Ir0nC0wb0y/Split-Flap/Electronics/SF_Master-Controller/Display Controller.xlsx

Reference | Qty | Value | DNP | Digikey Cart | Have
C2,C4,C8 | 3 | 10uF |  |  | x
C1,C3,C9,C10,C11 | 5 | 0.1uF |  |  | x
D1 | 1 | LTST-S220GKT |  | x
J1 | 1 | S2B-XH-A-1 |  | x
J2 | 1 | S4B-XH-A-1 |  | x
J3 | 1 | Pin Header (6 pin) |  |  | x
J4 | 1 | Pin Header (4 Pin) |  |  | x
Q1 | 1 | FMB2222A |  | x
R7 | 1 | 143R |  | x
R8 | 1 | 1k |  |  | x
R9,R10,R11,R12 | 4 | 1.8k |  | x
R13,R14,R15,R16 | 4 | 10k |  |  | x
R17,R18 | 2 | 1.8k | DNP |  | x
SW3,SW4 | 2 | SW_SPST |  | x
U2 | 1 | LD1117S33TR |  | x
U3 | 1 | LD1117S50TR |  | x
U4 | 1 | TCA9406DCUR |  | x
U5 | 1 | ESP32-WROOM-32E |  | x
