Ir0nC0wb0y/Split-Flap/Electronics/SF_Digit-Controller/Split-Flap_Digit-Controller_SMD.step

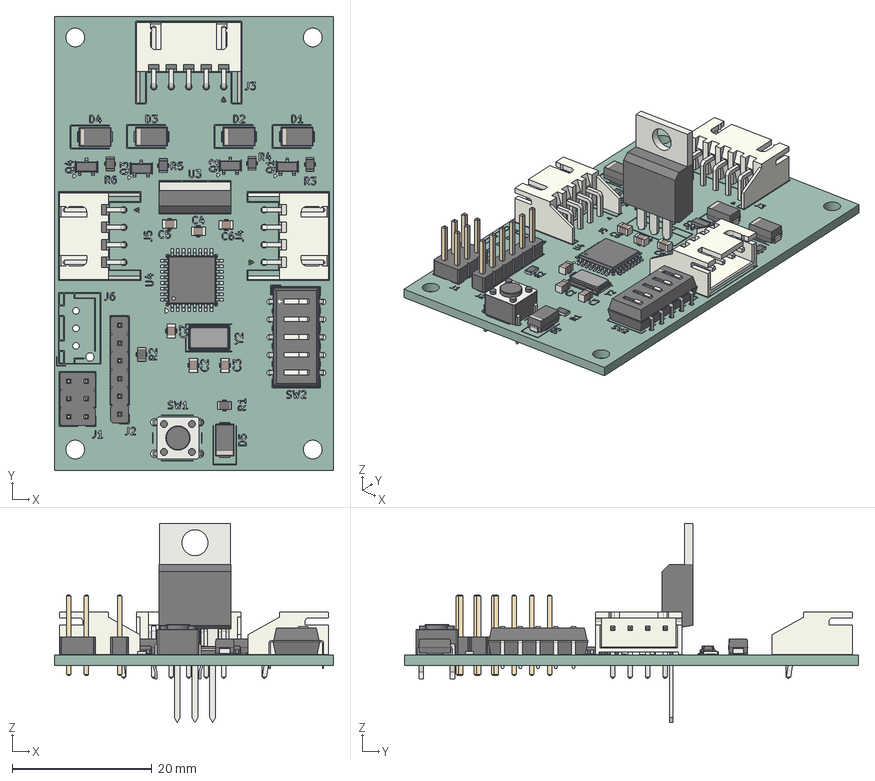
[picture p1: CAD file, 2025-06-14]
Electronics/SF_Digit-Controller/Split-Flap_Digit-Controller_SMD.step
40.0 x 65.0 x 28.5 mm
PinHeader_2x03_P2.54mm_Vertical
D_SMA x 5
TO-220-3_Vertical
C_0805_2012Metric x 6
SW_PUSH_6mm
SOT-23-3 x 4
R_0805_2012Metric x 6
Crystal_SMD_0603-2Pin_6.0x3.5mm
SW_DIP_SPSTx05_Slide_6.7x14.26mm_W7.62mm_P2.54mm_LowProfile
JST_XH_S4B-XH-A_1x04_P2.50mm_Horizontal x 2
TQFP-32_7x7mm_P0.8mm
PinHeader_1x06_P2.54mm_Vertical
JST_XH_S5B-XH-A_1x05_P2.50mm_Horizontal
Split-Flap_Digit-Controller_SMD_silkscreen
Split-Flap_Digit-Controller_SMD_PCB
