Ir0nC0wb0y/Split-Flap/Electronics/SF_Master-Controller/Display Controller.kicad_pcb

## KiCad design Electronics/SF_Master-Controller/Display Controller.kicad_pcb (2025-06-14)

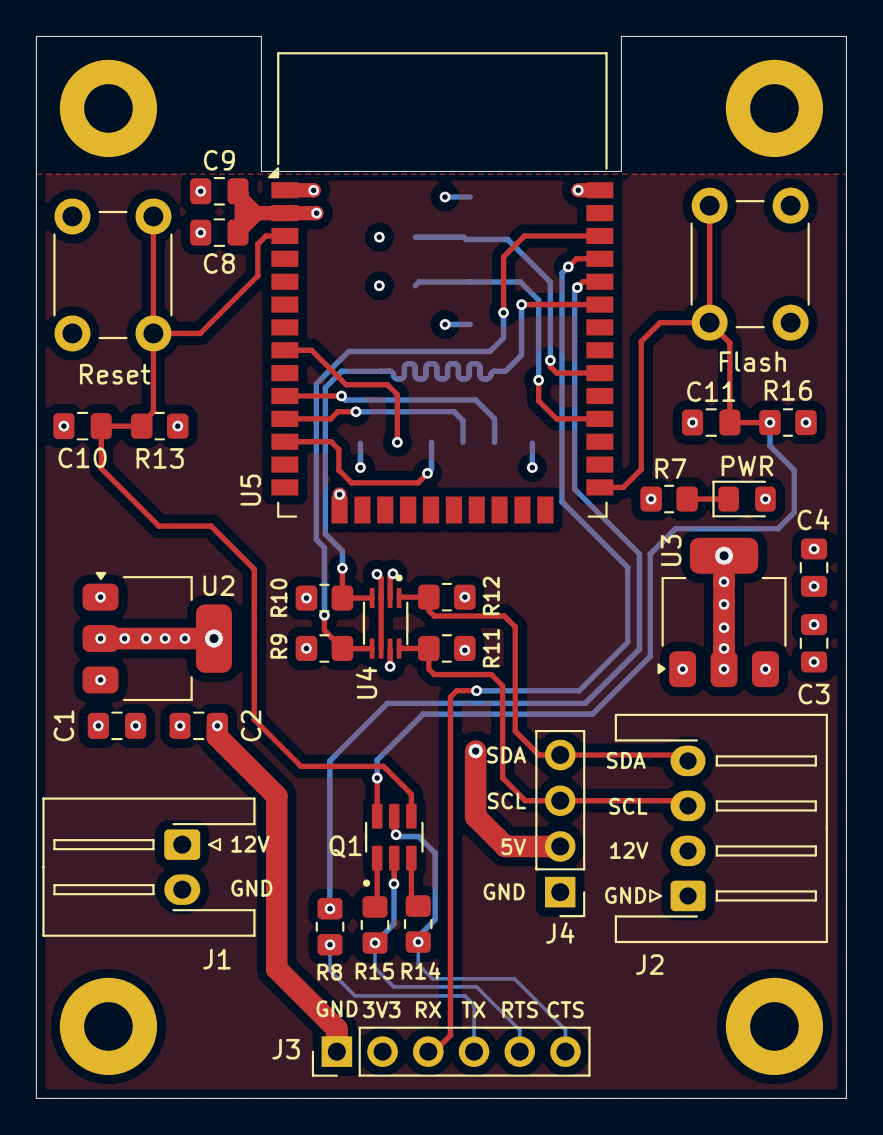
[picture p2: board Display Controller.kicad_pcb from above]

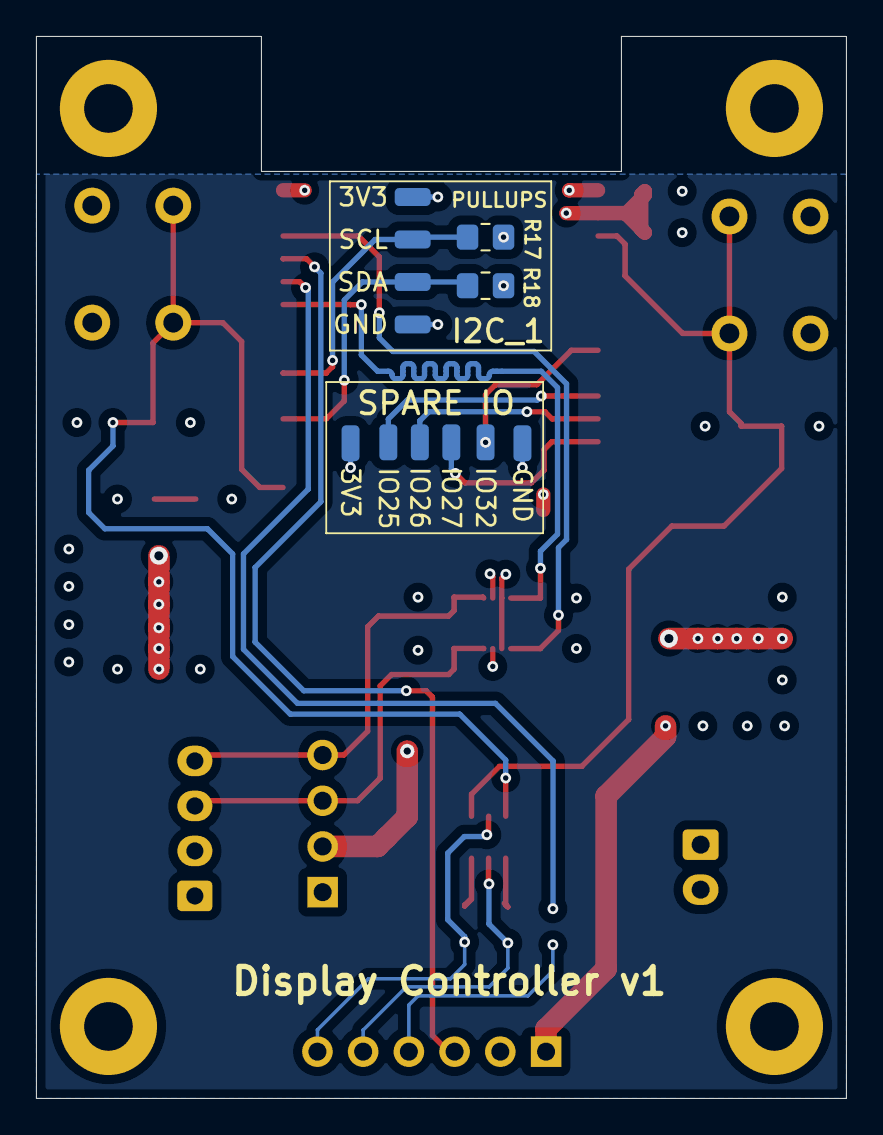
[picture p3: board Display Controller.kicad_pcb from below]

Board: 4 copper layers, 45.0 x 59.0 mm, 46 parts (12 on the bottom side), 24 nets.

Parts:
C1, C2, C3, C4: C; C_0805_2012Metric_Pad1.18x1.45mm_HandSolder
C8: 10uF; C_0805_2012Metric_Pad1.18x1.45mm_HandSolder
C9, C10, C11: 0.1uF; C_0805_2012Metric_Pad1.18x1.45mm_HandSolder
D1: LED; LED_0805_2012Metric_Pad1.15x1.40mm_HandSolder
H1, H2, H3, H4: MountingHole_Pad; MountingHole_2.7mm_M2.5_Pad
J1: Conn_01x02_Pin; JST_XH_S2B-XH-A-1_1x02_P2.50mm_Horizontal
J2: Conn_01x04_Pin; JST_XH_S4B-XH-A-1_1x04_P2.50mm_Horizontal
J3: Conn_01x06_Pin; PinHeader_1x06_P2.54mm_Vertical
J4: Conn_01x04_Pin; PinHeader_1x04_P2.54mm_Vertical
Q1: FMB2222A; SOT95P280X110-6N
R7: 150R; R_0805_2012Metric_Pad1.20x1.40mm_HandSolder
R8: 1k; R_0805_2012Metric_Pad1.20x1.40mm_HandSolder
R9, R10, R11, R12, R13, R14, R15, R16, R17, R18: 10k; R_0805_2012Metric_Pad1.20x1.40mm_HandSolder
SW3, SW4: SW_SPST; SW_PUSH_6mm_H4.3mm
TP1, TP2, TP3, TP4, TP5, TP6, TP7, TP8, TP9, TP10: TestPoint_Small; SolderWirePad_1x01_SMD_1x2mm
U2: LD1117S33TR_SOT223; SOT-223-3_TabPin2
U3: LD1117S50TR_SOT223; SOT-223-3_TabPin2
U4: TCA9406DCUR; SOP50P310X90-8N
U5: ESP32-WROOM-32E; ESP32-WROOM-32D

Connections:
+3V3: C2.1, C8.2, C9.2, J3.1, R9.1, R10.1, R13.1, R16.1, R17.1, R18.1, TP1.1, TP5.1, U2.2 (VO), U4.3 (VCCA), U4.6 (OE), U5.2 (VDD)
+5V: C4.1, D1.2 (A), J4.2, R11.1, R12.1, U3.2 (VO), U4.7 (VCCB)
+12V: C1.2, C3.2, J1.1, J2.2, U2.3 (VI), U3.3 (VI)
/ESP32/EN: C10.2, Q1.4, R13.2, SW3.2 (B), U5.3 (EN)
/ESP32/I2C_SCL_SPARE: R17.2, TP2.1, U5.30 (IO18)
/ESP32/I2C_SDA_SPARE: R18.2, TP3.1, U5.28 (IO17)
/ESP32/IO0: C11.2, Q1.6, R16.2, SW4.1 (A), U5.25 (IO0)
/ESP32/IO25: TP6.1, U5.10 (IO25)
/ESP32/IO26: TP7.1, U5.11 (IO26)
/ESP32/IO27: TP9.1, U5.12 (IO27)
/ESP32/IO32: TP10.1, U5.8 (IO32)
/I2C_SCL_5V: J2.3, J4.3, R11.2, U4.8 (SCL_B)
/I2C_SDA_5V: J2.4, J4.4, R12.2, U4.1 (SDA_B)
FTDI_CTS: J3.6, Q1.5, R14.1
FTDI_RTS: J3.5, Q1.2, R15.2
FTDI_RX: J3.3, U5.35 (TXD0/IO1)
FTDI_TX: R8.2, U5.34 (RXD0/IO3)
GND: C1.1, C2.2, C3.1, C4.2, C8.1, C9.1, C10.1, C11.1, J1.2, J2.1, J3.2, J4.1, R7.2, SW3.1 (A), SW4.2 (B), TP4.1, TP8.1, U2.1 (GND), U3.1 (GND), U4.2 (GND), U5.1 (GND), U5.15 (GND), U5.38 (GND)
I2C_SCL_3V3: R9.2, U4.5 (SCL_A), U5.36 (IO22)
I2C_SDA_3V3: R10.2, U4.4 (SDA_A), U5.33 (IO21)
unnamed: D1.1 (K), R7.1
unnamed: J3.4, R8.1
unnamed: Q1.1, R15.1
unnamed: Q1.3, R14.2
