Ir0nC0wb0y/Split-Flap/Electronics/SF_Digit-Controller/Split-Flap_Digit-Controller_SMD.kicad_pcb

## KiCad design Electronics/SF_Digit-Controller/Split-Flap_Digit-Controller_SMD.kicad_pcb (2025-05-09)

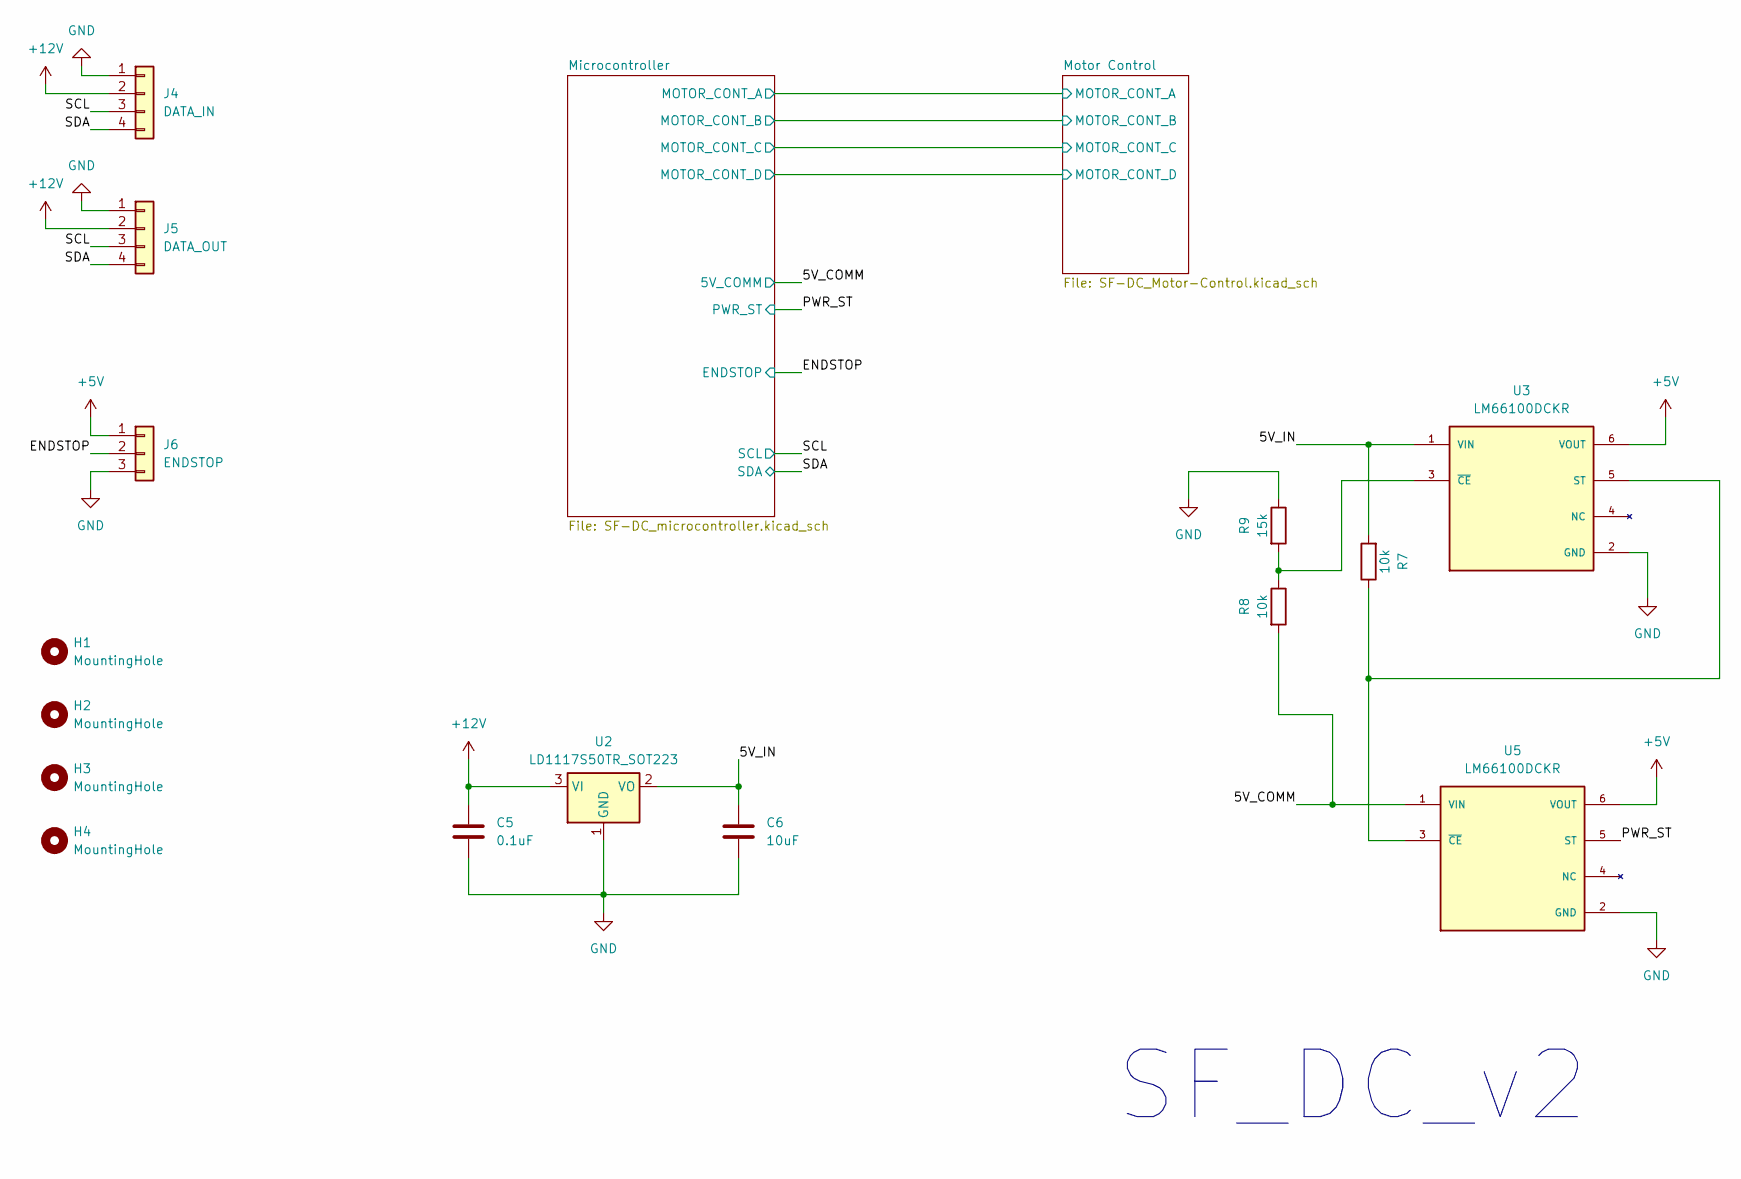
[picture p4: schematic Split-Flap_Digit-Controller_SMD.kicad_sch]

Parts:
C5: 0.1uF; LED_0805_2012Metric_Pad1.15x1.40mm_HandSolder
C6: 10uF; LED_0805_2012Metric_Pad1.15x1.40mm_HandSolder
H1, H2, H3, H4: MountingHole; MountingHole_2.7mm_M2.5_DIN965_Pad_TopBottom
J4: DATA_IN; JST_XH_S4B-XH-A-1_1x04_P2.50mm_Horizontal
J5: DATA_OUT; JST_XH_S4B-XH-A-1_1x04_P2.50mm_Horizontal
J6: ENDSTOP; JST_XH_S3B-XH-A-1_1x03_P2.50mm_Horizontal
R7, R8: 10k; R_0805_2012Metric_Pad1.20x1.40mm_HandSolder
R9: 15k; R_0805_2012Metric_Pad1.20x1.40mm_HandSolder
U2: LD1117S50TR_SOT223; SOT-223-3_TabPin2
U3, U5: LM66100DCKR; SOT65P210X110-6N; PARTREV Rev. A

Connections:
+5V: J6.1, U3.6 (VOUT), U5.6 (VOUT); also elsewhere on the board
+12V: C5.1, J4.2, J5.2, U2.3 (VI); also elsewhere on the board
/5V_COMM: R8.2, U5.1 (VIN); also elsewhere on the board
/5V_IN: C6.1, R7.2, U2.2 (VO), U3.1 (VIN)
/ENDSTOP: J6.2; also elsewhere on the board
/PWR_ST: U5.5 (ST); also elsewhere on the board
/SCL: J4.3, J5.3; also elsewhere on the board
/SDA: J4.4, J5.4; also elsewhere on the board
GND: C5.2, C6.2, J4.1, J5.1, J6.3, R9.1, U2.1 (GND), U3.2 (GND), U5.2 (GND); also elsewhere on the board
unnamed: R7.1, U3.5 (ST), U5.3 (~CE)
unnamed: R8.1, R9.2, U3.3 (~CE)

Notes on the sheet:
SF_DC_v2

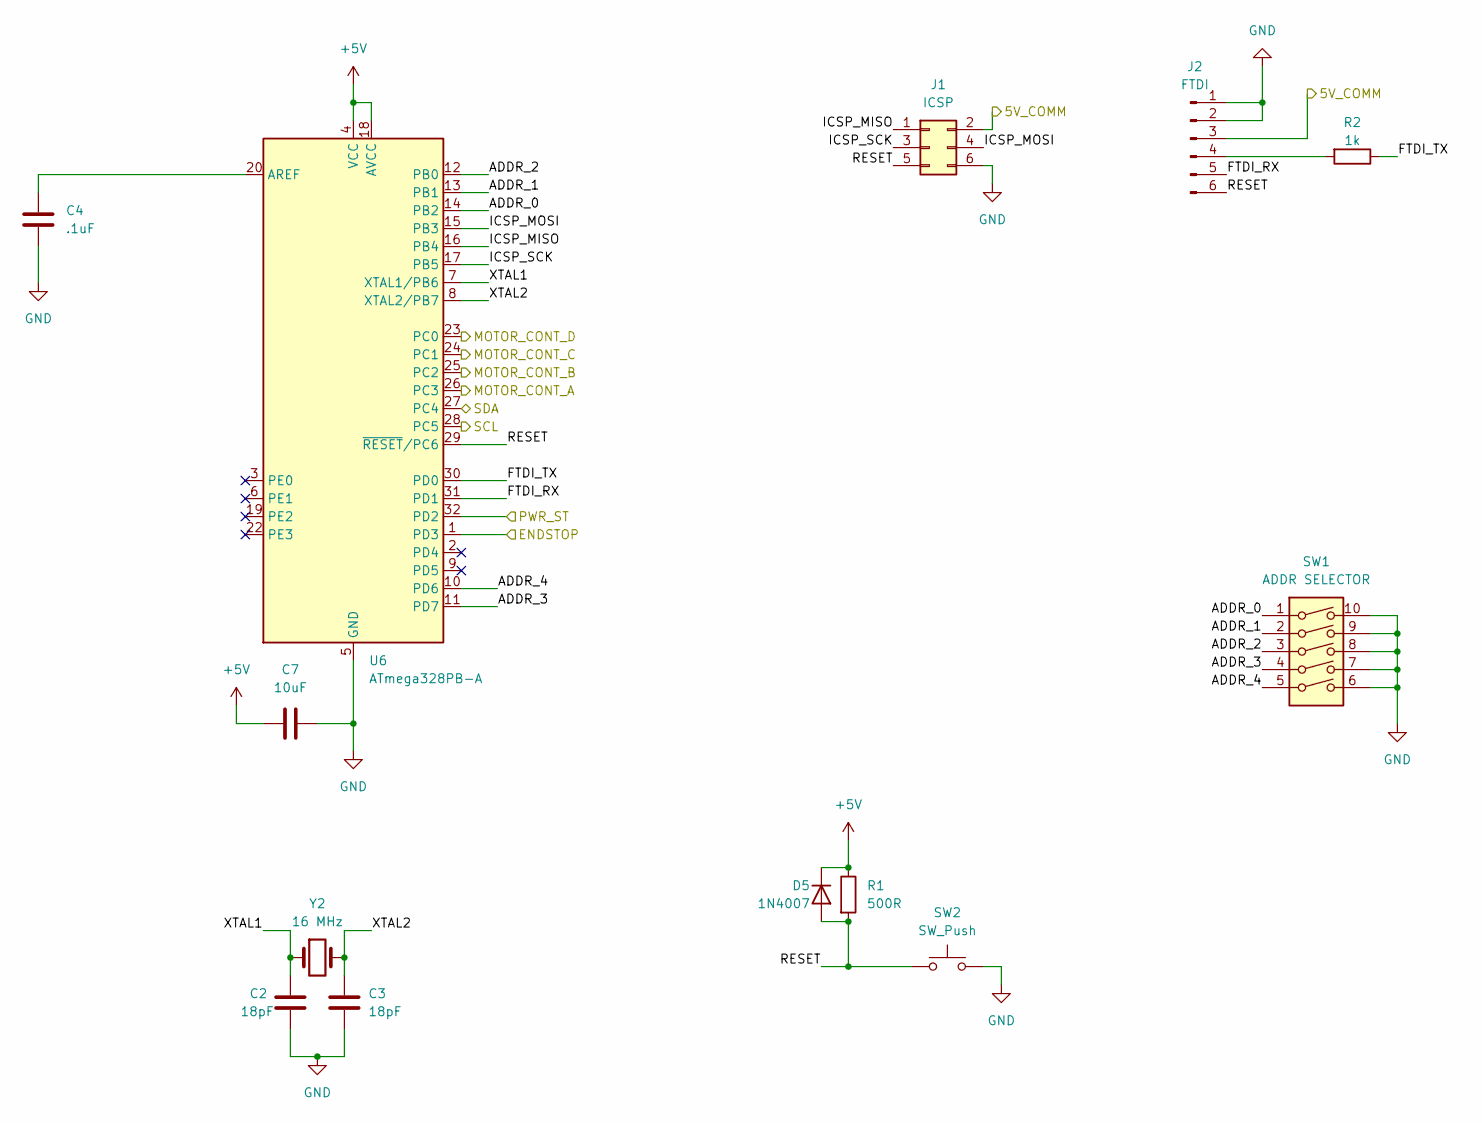
[picture p5: schematic SF-DC_microcontroller.kicad_sch]

Parts:
C2: 18pF; C_0805_2012Metric_Pad1.18x1.45mm_HandSolder; Part Number FG28C0G1H180JNT06
C3: 18pF; C_0805_2012Metric_Pad1.18x1.45mm_HandSolder; part_no FG28C0G1H180JNT06
C4: .1uF; C_0805_2012Metric_Pad1.18x1.45mm_HandSolder
C7: 10uF; C_0805_2012Metric_Pad1.18x1.45mm_HandSolder
D5: 1N4007; D_SMA_Handsoldering
J1: ICSP; PinHeader_2x03_P2.54mm_Vertical
J2: FTDI; PinHeader_1x06_P2.54mm_Vertical
R1: 500R; R_0805_2012Metric_Pad1.20x1.40mm_HandSolder
R2: 1k; R_0805_2012Metric_Pad1.20x1.40mm_HandSolder
SW1: ADDR SELECTOR; SW_DIP_SPSTx05_Slide_6.7x14.26mm_W7.62mm_P2.54mm_LowProfile
SW2: SW_Push; SW_PUSH_6mm
U6: ATmega328PB-A; TQFP-32_7x7mm_P0.8mm
Y2: 16 MHz; Crystal_SMD_0603-2Pin_6.0x3.5mm_HandSoldering

Connections:
+5V: C7.2, D5.1 (K), R1.1, U6.4 (VCC), U6.18 (AVCC); also elsewhere on the board
/5V_COMM: J1.2, J2.3; also elsewhere on the board
/ENDSTOP: U6.1 (PD3); also elsewhere on the board
/Microcontroller/ADDR_0: SW1.1, U6.14 (PB2)
/Microcontroller/ADDR_1: SW1.2, U6.13 (PB1)
/Microcontroller/ADDR_2: SW1.3, U6.12 (PB0)
/Microcontroller/ADDR_3: SW1.4, U6.11 (PD7)
/Microcontroller/ADDR_4: SW1.5, U6.10 (PD6)
/Microcontroller/FTDI_RX: J2.5, U6.31 (PD1)
/Microcontroller/FTDI_TX: R2.1, U6.30 (PD0)
/Microcontroller/ICSP_MISO: J1.1, U6.16 (PB4)
/Microcontroller/ICSP_MOSI: J1.4, U6.15 (PB3)
/Microcontroller/ICSP_SCK: J1.3, U6.17 (PB5)
/Microcontroller/MOTOR_CONT_A: U6.26 (PC3); also elsewhere on the board
/Microcontroller/MOTOR_CONT_B: U6.25 (PC2); also elsewhere on the board
/Microcontroller/MOTOR_CONT_C: U6.24 (PC1); also elsewhere on the board
/Microcontroller/MOTOR_CONT_D: U6.23 (PC0); also elsewhere on the board
/Microcontroller/RESET: D5.2 (A), J1.5, J2.6, R1.2, SW2.1, U6.29 (~RESET/PC6)
/Microcontroller/XTAL1: C2.2, U6.7 (XTAL1/PB6), Y2.1
/Microcontroller/XTAL2: C3.2, U6.8 (XTAL2/PB7), Y2.2
/PWR_ST: U6.32 (PD2); also elsewhere on the board
/SCL: U6.28 (PC5); also elsewhere on the board
/SDA: U6.27 (PC4); also elsewhere on the board
GND: C2.1, C3.1, C4.2, C7.1, J1.6, J2.1, J2.2, SW1.6, SW1.7, SW1.8, SW1.9, SW1.10, SW2.2, U6.5 (GND), U6.21 (GND); also elsewhere on the board
unnamed: J2.4, R2.2
unnamed: C4.1, U6.20 (AREF)

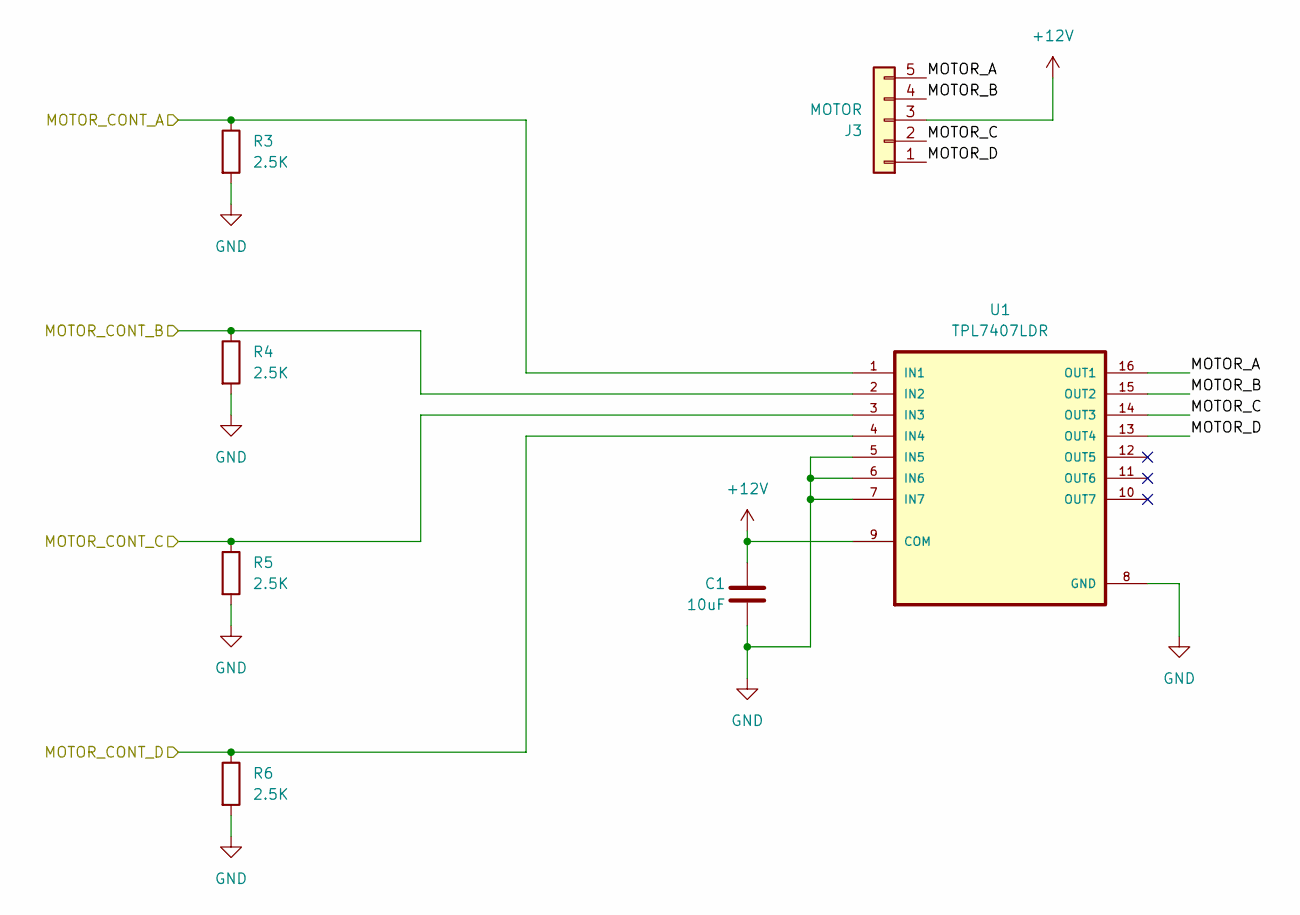
[picture p6: schematic SF-DC_Motor-Control.kicad_sch]

Parts:
C1: 10uF; R_0805_2012Metric_Pad1.20x1.40mm_HandSolder
J3: MOTOR; JST_XH_S5B-XH-A-1_1x05_P2.50mm_Horizontal
R3, R4, R5, R6: 2.5K; R_0805_2012Metric_Pad1.20x1.40mm_HandSolder
U1: TPL7407LDR; SOIC127P600X175-16N

Connections:
+12V: C1.2, J3.3, U1.9 (COM); also elsewhere on the board
/Microcontroller/MOTOR_CONT_A: R3.1, U1.1 (IN1); also elsewhere on the board
/Microcontroller/MOTOR_CONT_B: R4.1, U1.2 (IN2); also elsewhere on the board
/Microcontroller/MOTOR_CONT_C: R5.1, U1.3 (IN3); also elsewhere on the board
/Microcontroller/MOTOR_CONT_D: R6.1, U1.4 (IN4); also elsewhere on the board
/Motor Control/MOTOR_A: J3.5, U1.16 (OUT1)
/Motor Control/MOTOR_B: J3.4, U1.15 (OUT2)
/Motor Control/MOTOR_C: J3.2, U1.14 (OUT3)
/Motor Control/MOTOR_D: J3.1, U1.13 (OUT4)
GND: C1.1, R3.2, R4.2, R5.2, R6.2, U1.5 (IN5), U1.6 (IN6), U1.7 (IN7), U1.8 (GND); also elsewhere on the board

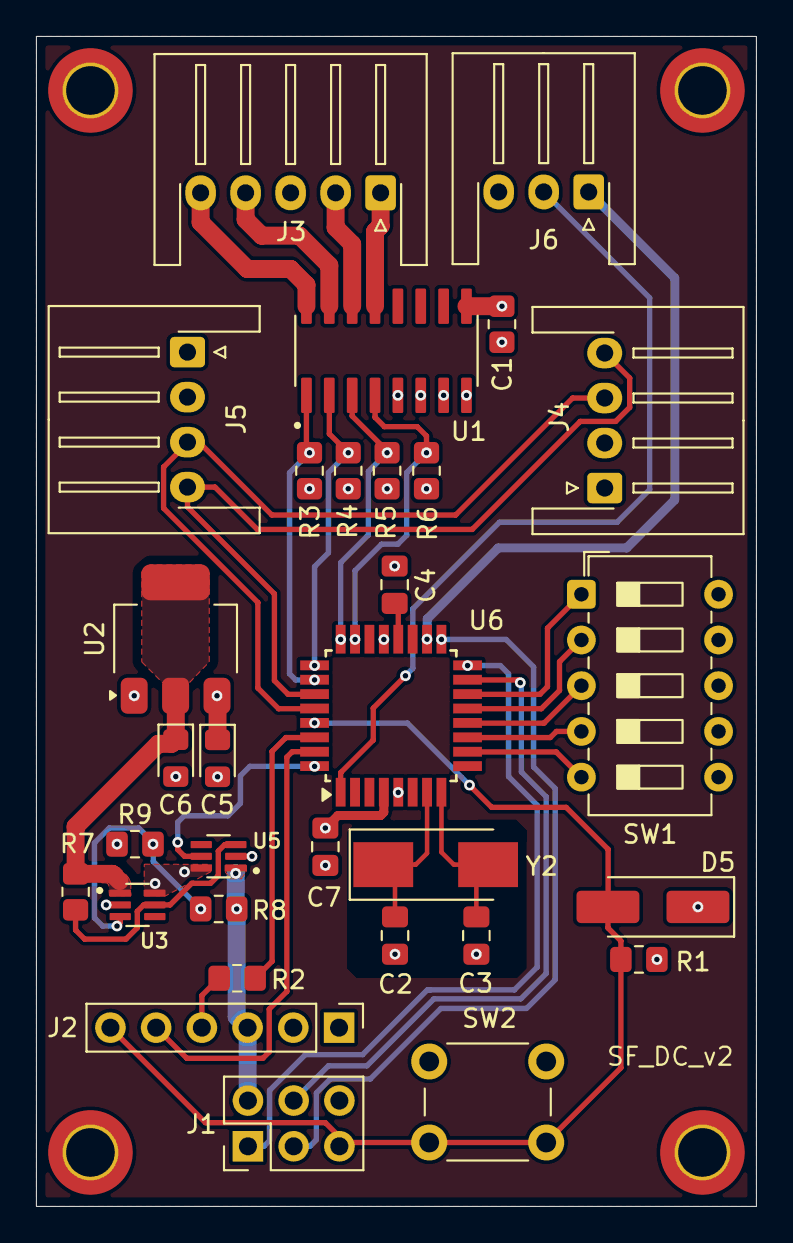
[picture p7: board Split-Flap_Digit-Controller_SMD.kicad_pcb from above]

Board: 4 copper layers, 40.0 x 65.0 mm, 35 parts (0 on the bottom side), 34 nets.
