Ir0nC0wb0y/Split-Flap/Electronics/SF_Hall-breakout/SF_Hall-breakout.kicad_pcb

## KiCad design Electronics/SF_Hall-breakout/SF_Hall-breakout.kicad_pcb (2025-05-09)

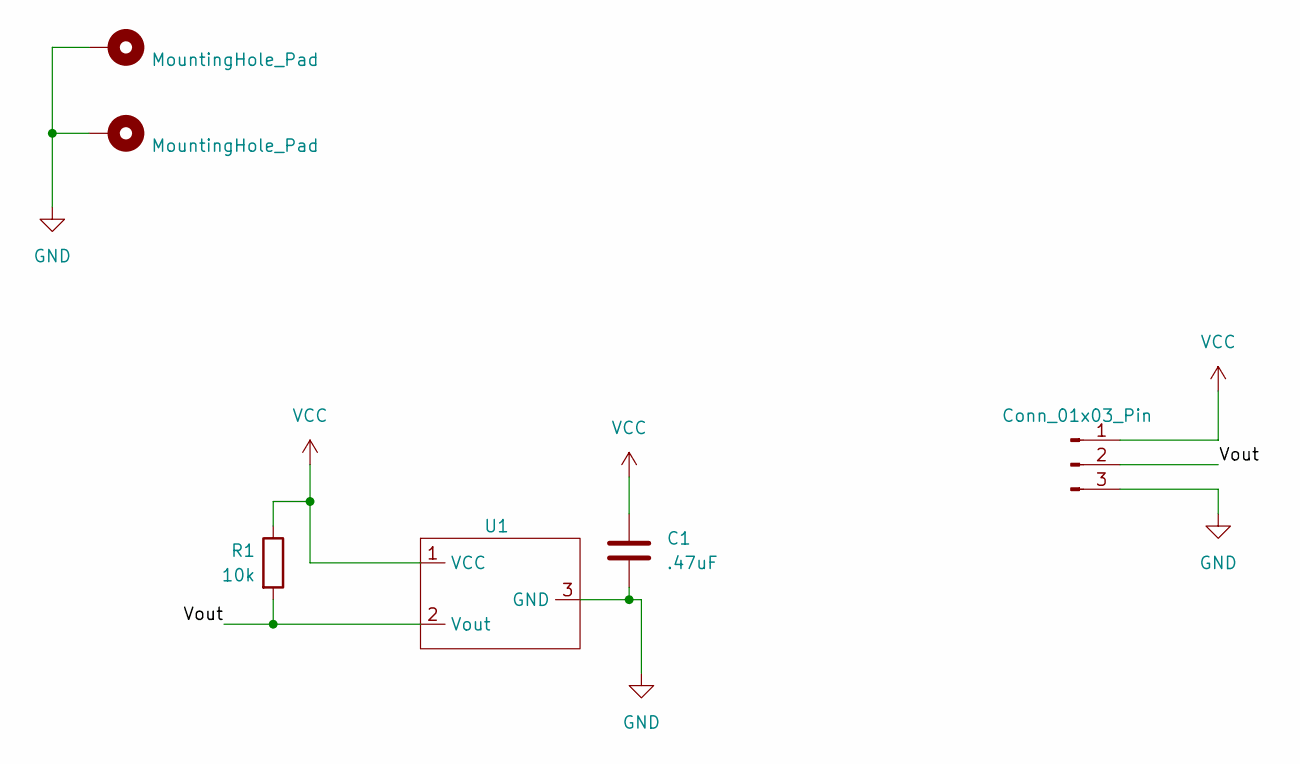
[picture p8: schematic SF_Hall-breakout.kicad_sch]

Parts:
C1: .47uF; C_0805_2012Metric_Pad1.18x1.45mm_HandSolder
H1, H2: MountingHole_Pad; MountingHole_2.2mm_M2_Pad
J1: Conn_01x03_Pin; PinHeader_1x03_P2.00mm_Vertical
R1: 10k; R_0805_2012Metric_Pad1.20x1.40mm_HandSolder
U1: SOT-23_Handsoldering

Connections:
/Vout: J1.2, R1.2, U1.2 (Vout)
GND: C1.2, H1.1, H2.1, J1.3, U1.3 (GND)
VCC: C1.1, J1.1, R1.1, U1.1 (VCC)

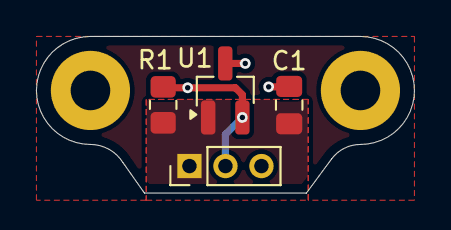
[picture p9: board SF_Hall-breakout.kicad_pcb from above]

Board: 2 copper layers, 21.0 x 8.7 mm, 6 parts (0 on the bottom side), 3 nets.
