Ir0nC0wb0y/Split-Flap/Software/SplitFlap_DigitControl/src/main.cpp

#include <Arduino.h>
#include <Wire.h>
#include <AccelStepper.h>

#include "expFilter.h"
#include "I2C_messages.h"

// coil order: blue, pink, yellow, orange
// wire order: yellow(A), orange(B), pink(C), blue(D)
// Stepper lib expects: blue-yellow, pink-orange


#define PIN_MOTOR_A 17  // yellow
#define PIN_MOTOR_B 16  // orange
#define PIN_MOTOR_C 15  // pink
#define PIN_MOTOR_D 14  // blue
#define PIN_ENDSTOP  3
#define PIN_ADDR_0  10
#define PIN_ADDR_1   9
#define PIN_ADDR_2   8
#define PIN_ADDR_3   7
#define PIN_ADDR_4   6

// I2C Setup
  void i2c_receiveEvent(int numBytesReceived);
  void I2C_requestEvent();
  bool newRxData = false;
  byte last_msg = 0;
  char msg_char;
  I2CTx_128 digit_status;
  void SetDigitStatus(bool status);

  // Address Setup
    int i2c_address = 0;
    #define I2C_ADDRESS_OFFSET 30
    int Address_Calc();

// Endstop Setup
  long last_endstop_trigger = 0;
  void Endstop_Interrupt();
  int is_homed = 0;
  long cross_endstop = 0;
  void Endstop_Cross();
  void Endstop_Calibrate();
  expFilter endstop_offset;
  #define ENDSTOP_OFFSET_WEIGHT 0.5
  int flap_offset = -96;
  

// Motor Setup
  #define HALFSTEP 8
  #define FULLSTEP 4
  AccelStepper stepper1(HALFSTEP, PIN_MOTOR_B, PIN_MOTOR_C, PIN_MOTOR_D, PIN_MOTOR_A);
  #define MOTOR_SPEED_HOMING   300.0
  #define MOTOR_SPEED_RUN     1500.0
  #define MOTOR_ACCEL         3000.0
  // Motor steps/rev filter
    expFilter motor_sr;
    #define MOTOR_SR_DEFAULT 4089  // was 4096
    #define MOTOR_SR_WEIGHT 0.95
    #define MOTOR_SR_DEBOUNCE 800
  #define MOTOR_CALIBRATE_TURNS 4
  #define MOTOR_CALIBRATE_SPEED 1000
  #define MOTOR_CALIBRATE_FORCE 100
  int motor_turns = -1;
  int motor_calibrate[MOTOR_CALIBRATE_TURNS+1][2] = {0};
  void Motor_Calibrate();
  void Motor_Home();


// Flap
  int flap_idx_current = -1;
  #define FLAPS_NUM 40
  #define FLAPS_ROTATION .025 // 1/40
  const char char_order[] = " ABCDEFGHIJKLMNOPQRSTUVWXYZ0123456789.:/";
  long Flap_Pos_Abs(int flap_idx);
  int Flap_Char(char incoming_char);
  void Flap_Idx2Pos(int flap_idx);
  void Flap_Move_Offset();
  
// Demo Function
  #define DEMO_PAUSE_TIME 2000
  unsigned long demo_pause_last = 0;
  int demo_state = 0;
  void Demo_Run();

/*
// Serial Comms
  int incomingByte = 0; // for incoming serial data
  #define SERIAL_BUFFER_LEN 16
  char message[SERIAL_BUFFER_LEN];
  void Serial_Read_Buffer();
*/

void setup() {
  // put your setup code here, to run once:
  Serial.begin(115200);
  Serial.println("Starting Sketch:");

  // Calculate I2C Address
  // Address Pins
    pinMode(PIN_ADDR_0, INPUT_PULLUP);
    pinMode(PIN_ADDR_1, INPUT_PULLUP);
    pinMode(PIN_ADDR_2, INPUT_PULLUP);
    pinMode(PIN_ADDR_3, INPUT_PULLUP);
    pinMode(PIN_ADDR_4, INPUT_PULLUP);
  i2c_address = Address_Calc();
  Serial.print("Starting I2C bus with address: "); Serial.println(i2c_address);
  // Start I2C bus with address
  Wire.begin(i2c_address);
  Wire.onReceive(i2c_receiveEvent);
  Wire.onRequest(I2C_requestEvent);

  // Set up pins
    //pinMode(PIN_MOTOR_A, OUTPUT);
    //pinMode(PIN_MOTOR_C, OUTPUT);
    //pinMode(PIN_MOTOR_B, OUTPUT);
    //pinMode(PIN_MOTOR_D, OUTPUT);

    // Endstop, also needs to become an interrupt
    pinMode(PIN_ENDSTOP, INPUT_PULLUP);
    attachInterrupt(digitalPinToInterrupt(PIN_ENDSTOP), Endstop_Interrupt, FALLING);

    
    
    
  // Endstop Offset Filter
    endstop_offset.setValue(flap_offset);
    endstop_offset.setWeight(ENDSTOP_OFFSET_WEIGHT);

  // Motor SR Filter
    motor_sr.setValue(MOTOR_SR_DEFAULT);
    motor_sr.setWeight(MOTOR_SR_WEIGHT);

  // Set up Motor
    stepper1.setSpeed(MOTOR_SPEED_RUN);         
    stepper1.setAcceleration(MOTOR_ACCEL); 
    stepper1.setMaxSpeed(MOTOR_SPEED_RUN);

  //Motor_Home();
  Motor_Calibrate();
  demo_pause_last = millis() - DEMO_PAUSE_TIME;
}

void loop() {

  // Handle I2C Messages
  if (newRxData) {
    // Display message
    Serial.println("***********");
    Serial.print(  "Message ID  : "); Serial.println((int)last_msg);
    Serial.print(  "Message Char: "); Serial.println(msg_char);
    Serial.println("***********");
    Serial.println();

    if ((int)last_msg == 33) {
      // Go to new char
      //Serial.println("Received expected message, moving to new position");
      int flap_id = Flap_Char(msg_char);
      Flap_Idx2Pos(flap_id);
    }

    newRxData = false;
  }

  if (stepper1.distanceToGo() != 0) {
    stepper1.run();
  } else {
    if (cross_endstop != 0) {
      Endstop_Cross();
    }
    stepper1.disableOutputs();
    SetDigitStatus(true);
  }

  // Force motor recalibration
  if (motor_turns >= MOTOR_CALIBRATE_FORCE) {
    Serial.println("Forcing recalibration ...");
    Motor_Calibrate();
    Serial.println(" ... Done!");
  }

}

void i2c_receiveEvent(int numBytesReceived) {
  if (!newRxData) {
    // Read first byte (message ID)
    if (Wire.available()){
      last_msg = Wire.read();
    }
    // put remaining data in appropriate structure
      // Message 33
      if (last_msg == 33) {
        // read remaining message
        if (Wire.available()){
          msg_char = Wire.read();
        }
      }
      // Message 34
      if (last_msg == 34) {
        // prepare for response
      }

    // Old single message read
      /*if (Wire.available()){
        msg_id = Wire.read();
      }
      if (Wire.available()){
        msg_char = Wire.read();
      }*/

    if (numBytesReceived > 2) {
      // dump the data
      while(Wire.available() > 0) {
          Wire.read();
      }
    }
    newRxData = true;
  }
  else {
    // dump the data
    while(Wire.available() > 0) {
        Wire.read();
    }
  }
}

void SetDigitStatus(bool status) {
  if (digit_status.status != status) {
    digit_status.status = status;
    Serial.print("Set digit status to: ");
      Serial.println(status);
  }
}

void I2C_requestEvent() {
  //Wire.write((byte*) &txData, sizeof(txData));
  if (last_msg == 34) {
    Wire.write((byte*) &digit_status, MESSAGE_SIZE_128);
  }
}

int Address_Calc() {
  bool bit0 = digitalRead(PIN_ADDR_0);
  bool bit1 = digitalRead(PIN_ADDR_1);
  bool bit2 = digitalRead(PIN_ADDR_2);
  bool bit3 = digitalRead(PIN_ADDR_3);
  bool bit4 = digitalRead(PIN_ADDR_4);

  Serial.print("Address bits: ");
    Serial.print(bit4);
    Serial.print(bit3);
    Serial.print(bit2);
    Serial.print(bit1);
    Serial.print(bit0);
    Serial.println();

  int addr = I2C_ADDRESS_OFFSET;

  if (bit0) {
    addr += 1;
  }

  if (bit1) {
    addr += 2;
  }

  if (bit2) {
    addr += 4;
  }

  if (bit3) {
    addr += 8;
  }

  if (bit4) {
    addr += 16;
  }

  return addr;
}


void Endstop_Interrupt() {
  if (is_homed == 1) {
    // used for homing the motor
    if (stepper1.currentPosition() > MOTOR_SR_DEBOUNCE && cross_endstop == 0) {
      // Set endstop position
      cross_endstop = stepper1.currentPosition();
      motor_turns++;
    }
  } /*else if (is_homed == 2) {
    // used for calibrating the motor
    if (stepper1.currentPosition() - cross_endstop >= MOTOR_SR_DEBOUNCE) {
      cross_endstop = stepper1.currentPosition();
      if (motor_turns >= 0) {
        motor_calibrate[motor_turns] = stepper1.currentPosition();
      }
      motor_turns++;
      //cross_endstop = stepper1.currentPosition();
    }
  } */else {
    // used for typical use
    stepper1.setCurrentPosition(flap_offset);
    is_homed = 1;
  }
}

void Endstop_Cross() {
  // calculate absolute position of flap index?
  long flap_pos = Flap_Pos_Abs(flap_idx_current);
  Serial.print("Flap Position:    ");
    Serial.println(flap_pos);

  long current_position = stepper1.currentPosition() - cross_endstop + flap_offset;
  Serial.print("Current Position: ");
    Serial.println(current_position);

  long position_error = current_position-flap_pos;
  Serial.print("Position error: ");
    Serial.println(position_error);
  if (position_error > motor_sr.getValue() * .15) {
    Motor_Calibrate();
  }

  stepper1.setCurrentPosition(current_position);
  //Serial.print("Updated position: "); Serial.println(stepper1.currentPosition());

  Serial.print("Crossed endstop, current turns: ");
    Serial.println(motor_turns);

  cross_endstop = 0;
}

void Endstop_Calibrate() {
  bool pin_state = digitalRead(PIN_ENDSTOP);
  // Routine to calibrate offset

  if (motor_turns >= 0) {
    if (!pin_state) {
      if (stepper1.currentPosition() - cross_endstop >= MOTOR_SR_DEBOUNCE) {
        cross_endstop = stepper1.currentPosition();
        // if pin LOW, set to column 0
        motor_calibrate[motor_turns][0] = stepper1.currentPosition();
      }
    } else {
      // if pin HIGH set to column 1
      motor_calibrate[motor_turns][1] = stepper1.currentPosition();
      motor_turns++;
    }
  } else if (pin_state) {
    motor_turns++;
  }
}

void Motor_Calibrate() {
  //is_homed = 2; // set interrupt to calibrate state
  SetDigitStatus(false);
  motor_turns = -1;
  Serial.print("Current SR value: ");
    Serial.println(motor_sr.getValue());

  attachInterrupt(digitalPinToInterrupt(PIN_ENDSTOP), Endstop_Calibrate, CHANGE);

  // Gather rotation data
  stepper1.setSpeed(MOTOR_CALIBRATE_SPEED);
  while (motor_turns <= MOTOR_CALIBRATE_TURNS) {
    stepper1.runSpeed();
    yield();
  }

  // filter collected data
  for (int i = 0; i < MOTOR_CALIBRATE_TURNS; i++) {
    int sr_turn = motor_calibrate[i+1][0] - motor_calibrate[i][0];
    int endstop_pass = -(motor_calibrate[i][1] - motor_calibrate[i][0]) / 2;
    //Serial.print("Turn ");
    //  Serial.print(i);
    //  Serial.print(", sr_turn: ");
    //  Serial.print(sr_turn);
    //  Serial.print(", endstop_pass: ");
    //  Serial.println(endstop_pass);
      
    if (abs(sr_turn - MOTOR_SR_DEFAULT) > MOTOR_SR_DEBOUNCE) {
      Serial.print("Turn ");
        Serial.print(i);
        Serial.print(" returned an error with ");
        Serial.print(sr_turn);
        Serial.println(" steps");
    } else {
      motor_sr.filter(sr_turn);
      Serial.print("Turn ");
        Serial.print(i);
        Serial.print(" filtering S/R: ");
        Serial.println(sr_turn);
      endstop_offset.filter(endstop_pass);
      Serial.print("Turn ");
        Serial.print(i);
        Serial.print(" filtering Endstop Offset: ");
        Serial.println(endstop_pass);
    }
  }
  Serial.print("New SR value: ");
    Serial.println(motor_sr.getValue());
  
  flap_offset = endstop_offset.getValue();
  Serial.print("New Endstop Offset value: ");
    Serial.println(flap_offset);
    

  // Not necessary after position calculation is corrected
  // Move off the endstop
  int new_position = stepper1.currentPosition() + ((int)motor_sr.getValue() + flap_offset - 400);
  stepper1.moveTo(new_position);
  while (stepper1.distanceToGo() != 0) {
    stepper1.run();
    yield();
  }

  // Return to regular endstop behavior
  attachInterrupt(digitalPinToInterrupt(PIN_ENDSTOP), Endstop_Interrupt, FALLING);
  cross_endstop = 0;
  motor_turns = 0;
  // Home Motor
  Motor_Home();

}

void Motor_Home() {
  is_homed = 0;
  stepper1.setSpeed(MOTOR_SPEED_HOMING);
  while (is_homed == 0) {
    stepper1.runSpeed();
    yield();
  }
  Serial.println("Motor is Homed!");
  Flap_Move_Offset();
  SetDigitStatus(true);
}

void Flap_Move_Offset() {
  stepper1.setSpeed(MOTOR_SPEED_RUN);
  stepper1.moveTo(0);
  while (stepper1.distanceToGo() != 0) {
    stepper1.run();
    yield();
  }
  flap_idx_current = 0;
  //cross_endstop = flap_offset;
  cross_endstop = 0;
  Serial.print("At position ");
    Serial.println(stepper1.currentPosition());
  delay(2000);
}

long Flap_Pos_Abs(int flap_idx) {
  float pos_float_abs = flap_idx * FLAPS_ROTATION;
  pos_float_abs = pos_float_abs * motor_sr.getValue();
  long pos_abs = (long)pos_float_abs;
  return pos_abs;
}

int Flap_Char(char incoming_char) {
  int index = -1;
  char * pch;
  pch=strchr(char_order,incoming_char);
  if (pch != nullptr) {
    index = pch - char_order;
  }
  return index;
}

void Flap_Idx2Pos(int flap_idx) {
  // Calculation for absolute movement
    SetDigitStatus(false);
    long flap_pos_new = Flap_Pos_Abs(flap_idx);
    long stepper_position = stepper1.currentPosition();
    // new pos > zero pos (must pass go to get to new position)
    if (stepper1.currentPosition() < 0) {
      if (flap_pos_new - motor_sr.getValue() > stepper1.currentPosition()) {
        flap_pos_new = flap_pos_new - motor_sr.getValue();
      }
    } else if (flap_pos_new < stepper_position) {
      flap_pos_new += motor_sr.getValue();
    }

    // 

    // Communicate the move
    //Serial.print("Moving to character id ");
    //  Serial.print(flap_idx);
    //  Serial.print(" at position ");
    //  Serial.println(flap_pos_new);

  stepper1.setSpeed(MOTOR_SPEED_RUN);
  //stepper1.moveTo(position);
  stepper1.moveTo(flap_pos_new);
  flap_idx_current = flap_idx;
}
