Ir0nC0wb0y/Split-Flap/Software/SF_Master/src/functions_display.h

#ifndef FUNCTIONS_DISPLAY_H
#define FUNCTIONS_DISPLAY_H
#include <Arduino.h>

#include "functions_i2c.h"
#include "functions_time.h"

#define FLAPS_NUM 40
#define COUNTDOWN_SEC_YEAR  31536000
#define COUNTDOWN_SEC_MON    2419200
#define COUNTDOWN_SEC_WEEK    604800
#define COUNTDOWN_SEC_DAY      86400
#define COUNTDOWN_SEC_HOUR      3600
#define COUNTDOWN_SEC_MIN         60

enum Alignment {
  ALIGN_LEFT = 1,
  ALIGN_CENTER,
  ALIGN_RIGHT
};

// Settings from main
  extern String display_string;
  extern bool use_12_hr_time;
  extern unsigned long display_framerate;
  //extern unsigned long display_frame_last;
  extern time_t countdown_event;
  extern bool   countdown_years_show;
  extern bool   countdown_months_show;
  extern bool   countdown_weeks_show;
  extern bool   countdown_days_show;
  extern bool   countdown_hours_show;
  extern bool   countdown_minutes_show;
  extern int display_alignment;
  //extern const char char_order[41];
  extern String character_order;

// Values taken from "functions_time"
  // Time
    extern int time_hour_raw;
    extern int time_minute;
  // Date
    extern int date_year;
    extern int date_month;
    extern int date_day;


void send_String(String& str);
void string_align(String& str, char pad_char, int alignment, int length);
bool HandleDisplay();
// Pretty Serial
  void Display_PrettySerial();
// Countdown            (frame ID:  1)
  void Display_Countdown();
// Display Message(s)   (frame ID:  2)
  void Display_Message();
// Time                 (frame ID:  3)
  void Display_Time();
// Date                 (frame ID:  4)
  void Display_Date();
// Discord Message      (frame ID: XX)
// Demo Function        (frame ID: 99)
  void Demo_Run(bool all_digits = false);
  char Demo_NewChar(int demo_state);

void ClearDisplay();

#endif
