Ir0nC0wb0y/Split-Flap/(commit log)

2025-05-09 Initial Release
    [SF-DC_HE-BREAKOUT.kicad_sch, SF-DC_Motor-Control.kicad_sch, SF-DC_microcontroller.kicad_sch, SF_Hall-breakout.kicad_pcb, SF_Hall-breakout.kicad_sch, Split-Flap_Digit-Controller_SMD.kicad_pcb, Split-Flap_Digit-Controller_SMD.kicad_sch]
2025-05-18 Added calibrate routine separate from demo
2025-05-19 Fixed Positioning Calculations
    All methodology now the same
    [main.cpp]
2025-06-05 Added simple I2C comms and upgrade calibration
    New calibration routine takes position of pre and post endstop crossing and averages
2025-06-14 Added Master Controller design and cleanup naming
    [DC_Power.kicad_sch, Display Controller.kicad_pcb, Display Controller.kicad_sch, Display Controller.xlsx, SF-DC_HE-BREAKOUT.kicad_sch, SF-DC_Motor-Control.kicad_sch, SF-DC_microcontroller.kicad_sch, Split-Flap_Digit-Controller_SMD.kicad_pcb]
2025-07-03 Update for production microcontroller (esp32)
2025-07-21 I2C handling of multiple digits
2025-07-22 fix(SF_Master): use LittleFS instead of SPIFFS
    [main.cpp]
2025-07-27 Added create AP if STA doesn't connect
    [main.cpp]
2025-08-02 Added countdown, flashed
    Still have an issue of the unit not displaying (remains null character)
    [functions_display.cpp, functions_display.h, functions_i2c.h, functions_time.cpp, functions_webserver.cpp, functions_wifi.cpp, main.cpp]
2025-08-03 Improve display and I2C debug logging and timing
    Added detailed Serial output to send_String for better visibility of message sending. Refactored send_character to use a non-blocking wait loop with a configurable DIGIT_READY_WAIT interval. Introduced debug I2C delay injection in I2C_Message_34 for testing. Updated function declarations and header consistency.
2025-08-03 Fix missing newline in send_String completion log
    Changed Serial.print to Serial.println for the 'ms' suffix in send_String, ensuring the completion message is properly terminated with a newline.
    [functions_display.cpp]
2025-08-04 Refactor display, time, and WiFi handlers to return status
    Updated HandleDisplay, handle_time, and checkWiFi to return a boolean indicating if they performed an action. Added timing and status reporting in main loop for performance diagnostics. Improved display frame management and added frame completion logic. Minor adjustment to I2C debug delay probability.
2025-08-04 Refactor display, webserver, and timing logic
    Improved frame selection logic in HandleDisplay by using a temporary variable for next frame calculation. Updated I2C debug delay for more realistic testing. Webserver now syncs display_string and uses address_count for message length. Added address_count and display_string externs to header. Adjusted main loop timing and event for more accurate performance logging and updated countdown_event for testing.
2025-08-04 Optimize display string updates and update comments
    Added a check in send_String to only send characters that differ from the current display, reducing unnecessary transmissions. Updated comments in main.cpp to clarify the time format for countdown_event test values. Commented out verbose serial output in Display_Countdown for cleaner logs.
2025-08-09 Refactor display and countdown variable organization
    Grouped related display and countdown variables for improved code clarity in main.cpp. Added message parsing logic and frame handling refinements in functions_display.cpp to support message chunking and better frame management.
